Th3Ruiz/Proyecto-Dise-o-Mecatronico/Imagen proyecto final.jpg

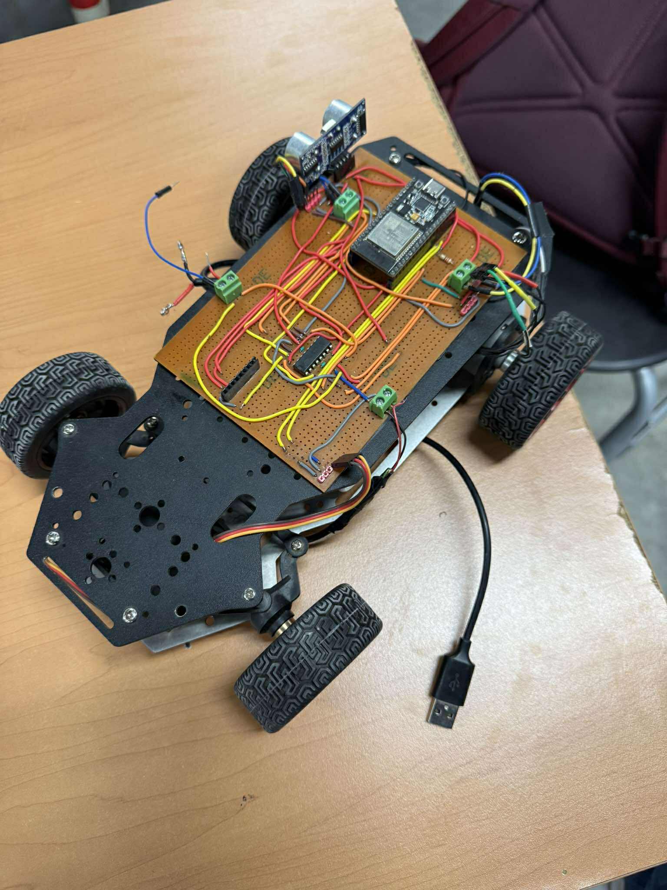
Imagen proyecto final.jpg
