Th3Ruiz/Proyecto-Dise-o-Mecatronico/Proyecto_diseno_mecatronico-3.pdf

Instituto de Ingeniería y Tecnología Diseño Mecatronico

# Sistema de Estacionamiento en Paralelo para Plaforma movil tipo Ackermann

Luis Armando Enciso Nava | 215766
Luis Eli Soto Arredondo | 201018
Francisco Javier Hernandez Gutierrez 201215
Angel Reynaldo Garcia Saucedo | 201957
Jorge Ivan Ruiz Espinoza | 201621

21 de mayo de 2025

## Índice

1. Introducción | 4
2. Desarrollo | 5
3. Anexos | 23

## Índice de figuras

1. | estacionamiento en paralelo | | 5
2. | Plataforma movil | | 6
3. | ESP32 | | 6
4. | Sensor láser | | 7
5. | Motoreductor de 12V | | 7
6. | Sensor de acelerómetro y giroscopio MPU-6050 | | 8
7. | Bateria de 12v | | 9
8. | Servmotor | | 9
9. Plano cartesiano en el primer cuadrante de tan⁻¹
| 10
10. Plano cartesiano en el primer cuadrante de tan⁻¹
(y, x) | 10
11. Diagrama del Sistema de Adquisición de datos y control del Robot Ackermann | 17
12. Chasis | 19
13. Centro de masa de Plataforma móvil | 21
14. Centro de cara de la rueda | 21
15. Representación de marcos coordenados aplicados a las ruedas y brazo de giro del sistema
móvil | 22
16. Planos de plataforma movil tipo ackermann | 29

## 1. Introducción

La adquisición de datos en un entorno dinámico es un proceso fundamental que permite la recopilación de información mediante diversos métodos y tecnologías, con el objetivo de analizar y comprender el funcionamiento del sistema en estudio. En la industria y la investigación, esta práctica se ha con-vertido en un pilar esencial, especialmente en el desarrollo de plataformas móviles capaces de ejecutar maniobras.
Este proyecto propone la implementación de un sistema de estacionamiento en paralelo para una plataforma con configuración Ackermann. Para ello, se utilizarán dispositivos ESP32, los cuales serán programados para que sean capaces tanto del control de movimientos de la plataforma móvil como de la recopilación y procesamiento de datos esenciales. A través de la programación, el sistema realizará las mediciones necesarias para ejecutar la maniobra de estacionamiento . Además, los datos obtenidos serán transmitidos a otros dispositivos, permitiendo así la simulación digital del movimiento y su implementación en el modelo físico.

### 1.1. Objetivo

Implementar un sistema de estacionamiento en paralelo para una plataforma móvil tipo Ackermann.

### 1.2. Objetivos Particulares

Equipar una plataforma móvil tipo Ackermann con un sistema con la propiedad de realizar maniobras de estacionamiento en paralelo.

Crear una representación tridimensional de la plataforma de manera sincronizada con su ejecución física.

Implementar un sistema de comunicación entre el microcontrolador, la simulación 3D y el robot móvil físico.

## 2. Desarrollo

### 2.1. Estacionamiento en Paralelo

Es una maniobra en la que se busca estacionar la plataforma movil ocupando el espacio entre dos objetos los cuales ya están previamente estacionados. Se define estacionamiento paralelo porque, una vez estacionado el automóvil luego de la maniobra, este queda en paralelo al borde de la calzada.

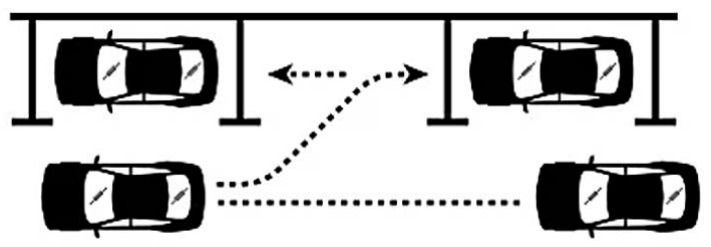
[picture p2: figure]

Figura 1: estacionamiento en paralelo

### 2.2. Plataforma de desarrollo robótico en Linux

Para esta parte se planea usar ROS2 que proviene de las siglas en inglés de Robot Operating System el cual es un conjunto de bibliotecas y herramientas de software que sirven para construir aplicaciones de robotica en linux. Desde controladores hasta algoritmos de vanguardia y con potentes herramientas para desarrollo. ROS2 tiene todo lo que se podría necesitar a la hora de realizar proyectos de robótica ademas es muy accesible ya que es de codigo abierto.

### 2.3. Lista de Materiales

Chasis con dirección tipo Ackerman

Microcontrolador ESP-32

Sensor láser ”time of flight”VL053X

Motores con Encoder de dos canales

Unidad de medición inercial MPU

Batería 12v 3600 mah

Servomotor MG996R

Buzzer

### 2.3.1. Chasis con direción tipo Ackerman

El chasis está equipado con un par de motores de reducción de CC de alto rendimiento, neumáticos de goma, servo digital MG-996R. El chasis adopta una estructura de aleación de aluminio totalmente metálica con una superficie anodizada. El chasis adopta una estructura de dirección Ackerman. Ambos motores cuentan con un encoder rotativo de dos canales, el cual necesita una alimentación de 3.3v para su correcto funcionamiento. Dichos motores funcionan con un voltaje de 12v.

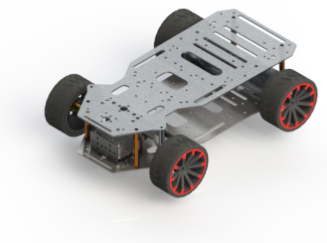
[picture p3: figure]

Figura 2: Plataforma movil

### 2.3.2. Microcontrolador ESP-32

El ESP32 es un microcontrolador creado por Espressif Systems. Este dispositivo es el sucesor del ESP8266. Tiene WiFi y Bluetooth y funciona con bajo consumo. Esto lo hace perfecto para proyectos que usan baterías. Además, es más rápido que un Arduino. Tiene pines sensibles al tacto y un sensor de efecto Hall.

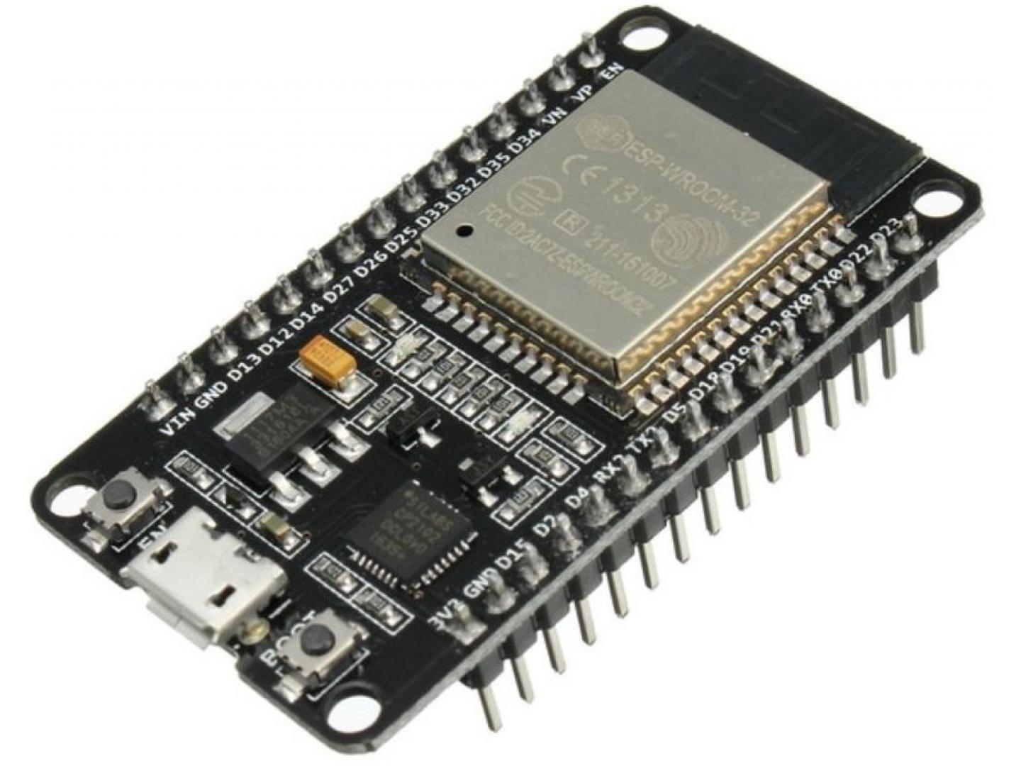
[picture p4: figure]

Figura 3: ESP32

### 2.3.3. Sensor láser ”time of fly”VL053X

Sensor laser, tambien llamado ”time of fly.es un sensor muy preciso el cual proyecta un laser para medir la distancia hacia un objeto

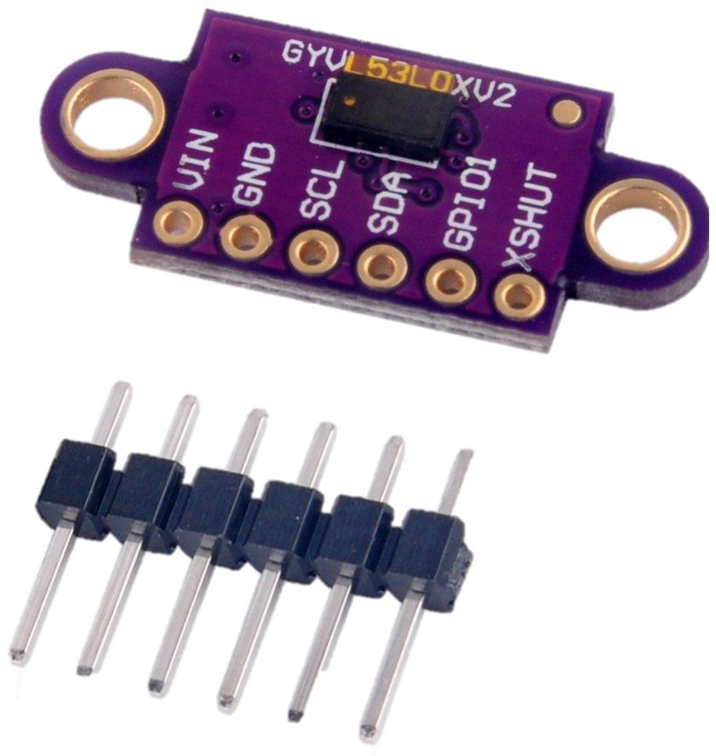
[picture p5: figure]

Figura 4: Sensor láser

### 2.3.4. Motorreductor 12V con encoder de dos canales

Motorreductor de 12 voltios, el cual tiene acoplado un encoder de dos canales de efecto hall de 350 rpm

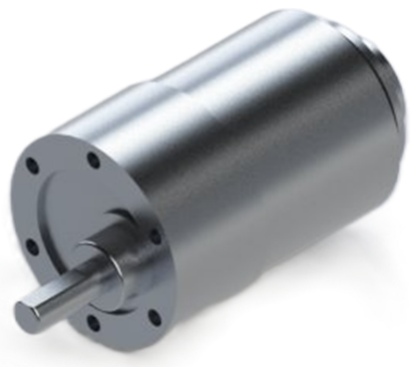
[picture p6: figure]

Figura 5: Motoreductor de 12V

### 2.3.5. MPU-6050

El MPU-6050 es una unidad de medición inercial (IMU) de seis grados de libertad (6DOF) fabricado por Invensense, que combina un acelerómetro de 3 ejes y un giroscopio de 3 ejes.

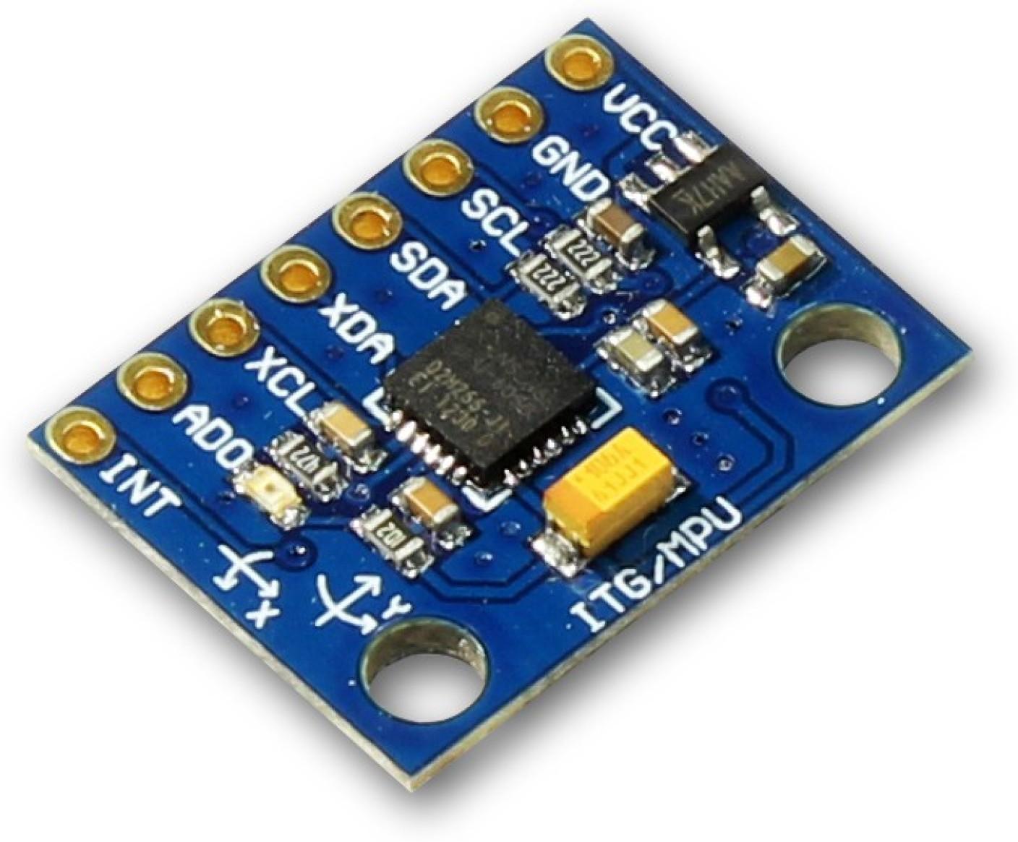
[picture p7: figure]

Figura 6: Sensor de acelerómetro y giroscopio MPU-6050

Acelerómetro

Mide la aceleración lineal en tres ejes (x, y, z ).

Detecta cambios en la velocidad del objeto.

Proporciona datos sobre la orientación del objeto en el espacio.

Giroscopio

Mide la rotación angular en tres ejes (x, y, z ).

Detecta cambios en la orientación del objeto.

Proporciona datos sobre la velocidad angular del objeto.

Funcionalidades del MPU6050

Detección de movimiento y orientación.

Estabilización de imágenes y videos.

Control de drones y robots.

Seguimiento de gestos y movimientos en dispositivos móviles.

Monitoreo de actividad física en dispositivos wearables.

Navegación en sistemas de posicionamiento global (GPS).

### 2.3.6. Bateria de 12V 3600 mah

Bateria de 12v de 3600 mah, ideal para alimentar nuestro circuito.

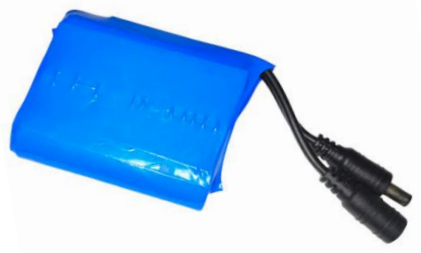
[picture p8: figure]

Figura 7: Bateria de 12v

### 2.3.7. Servomotor MG996R

Servo motor que será ocupado para la dirección de nuestro motor, dicho servomotor soporta hasta 10 kg y funciona con 5vdc.

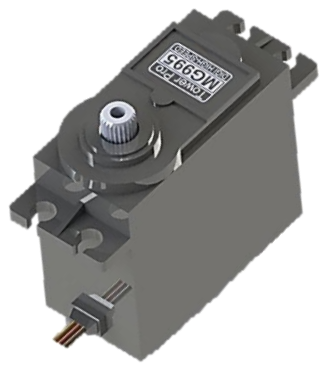
[picture p9: figure]

Figura 8: Servmotor

Algoritmos de Control y configuración
Implementaremos los algoritmos de control para los motores y el servomotor, usando Bluetooth para enviar comandos desde una aplicación de Android. Calcular RPM, velocidad angular y velocidad lineal a partir de las lecturas de los encoders.
Despues definiremos las configuraciones geométricas del sistema de dirección Ackermann y los ángulos de las ruedas, para garantizar un movimiento preciso y menor desgaste en las ruedas.
Teorema de tan⁻¹
(2)
La función tan⁻¹
(2) o tan⁻¹
(y, x), también conocida como la función arcotangente de dos parámetros, es una función matemática que calcula el ángulo θ entre el eje positivo de las x y el punto (x, y) en el plano cartesiano. Este ángulo θ se expresa en radianes y está limitado a un rango de −π a π.

tan⁻¹
(y, x) se utiliza para convertir coordenadas cartesianas (x, y) en coordenadas polares (r, θ), donde:

r = distancia desde el origen hasta el punto (x, y)

θ = es el angulo entre el x positivo y la linea que conecta con el origen en el punto (x, y).

Esta función toma en cuenta el signo de ambos parámetros para determinar el cuadrante correcto del angulo.

x

y

1 | 2 | 3

1

2

3

punto

Origen

Figura 9: Plano cartesiano en el primer cuadrante de tan⁻¹

x

y

1 | 2 | 3

1

2

3

punto

Origen

r

θ

Figura 10: Plano cartesiano en el primer cuadrante de tan⁻¹ (y, x)

Las figuras muestran un plano cartesiano donde se representa un punto en el primer cuadrante y la línea que une el origen con dicho punto. Usamos la función atan2(y,x) para calcular el ángulo de esta línea respecto al eje x positivo, ya que atan2 considera correctamente el signo de ambos parámetros, permitiendo identificar el cuadrante exacto. Esto es fundamental en la dirección Ackermann de un co-che, porque necesitamos conocer con precisión la orientación del vehículo para controlar adecuadamente el giro de las ruedas y su trayectoria.

Donde podemos aplicar este teorema:

Gráficos por computadora: Para rotar objetos en un plano.

Robótica: Para determinar la orientación de un robot en un espacio bidimensional.

Navegación: Para calcular la dirección entre dos puntos en un mapa

### 2.4. Dirección Ackerman

La ecuación para calcular el ángulo de dirección Ackerman en un sistema de dirección de una plataforma móvil programable se basa en la geometría de la configuración de las ruedas. La idea principal detrás del diseño de Ackermann es que las ruedas delanteras estén alineadas de manera que todos los radios de giro de las ruedas se crucen en el centro de rotación del vehículo, lo que minimiza el deslizamiento y el desgaste de las ruedas.
Este diseño se basa en la geometría de la configuración de las ruedas, donde los radios de giro de todas las ruedas se cruzan en un punto común, optimizando así la maniobrabilidad del vehículo. La fórmula básica para el ángulo de dirección Ackerman para las ruedas delanteras utilizando el teorema de tan⁻¹
(y, x) para obtener el ángulo de giro más exacto se muestra en la ecuación 1:

θi = tan⁻¹

L
Ri
(1)

donde:

θi es el ángulo de dirección de la rueda delantera medido en grados

i (donde i puede ser 1 o 2 para las ruedas del lado izquierdo o derecho, respectivamente)

L es la distancia entre el eje de las ruedas delanteras (ancho del tren delantero) medida en metros(m)

Ri es el radio de giro de la rueda i medida en metros(m)

Para un diseño de dirección Ackerman ideal, las ruedas delanteras deben estar orientadas de manera que todos los radios de giro de las ruedas se crucen en el mismo punto en el suelo. Esto asegura que las ruedas interiores y exteriores del vehículo giren con los ángulos adecuados para el radio de giro deseado.
Para calcular la velocidad lineal y angular de un vehículo que utiliza una dirección Ackerman, primero debemos entender cómo las ruedas afectan el movimiento del vehículo. Aquí está el proceso: La velocidad lineal (v) del vehículo se calcula como en la ecuación 2:
v = r · ω | (2)

donde:

r es el radio de giro del vehículo

ω es la velocidad angular de rotación del vehículo alrededor del centro de giro

La velocidad angular (ω) del vehículo se relaciona con el radio de giro (r) y la velocidad lineal (v) en la ecuación 3:

ω =

v
r

(3)

Cálculo del Radio de Giro
Para calcular el radio de giro usando tan⁻¹
(y, x), necesitamos expresar la relación en términos de coordenadas cartesianas (x, y). Podemos considerar:

x como la diferencia en la posición horizontal

y como la diferencia en la posición vertical

La ecuación para el radio de giro, llamada Ackermann, se representa en la ecuación 4:

Ackermann = tan⁻¹

d1

d1
tan(β) − d2

!
(4)

donde:

d1 es la distancia entre los ejes delantero y trasero del vehículo

d2 es la distancia entre las ruedas del mismo eje

β es el ángulo de giro interior de la rueda

Esta ecuación asegura que las ruedas del vehículo giren alrededor de un punto común, lo que mejora la estabilidad y reduce el desgaste de los neumáticos.

Angulo de giro de rueda interior ´

β = tan⁻¹

L
r −

W
2

!
(5)

donde:

L es la distancia entre ejes

r es el radio de giro

W es la distancia entre las ruedas del mismo eje (vía)

Angulo de giro de rueda exterior ´

α = tan⁻¹

L
r +

W
2

!
(6)

donde:

L es la distancia entre ejes (batalla)

r es el radio de giro

W es la distancia entre las ruedas del mismo eje (vía)

Porcentaje de Ackermann
El porcentaje de Ackermann se puede calcular como en la ecuación 7:

Porcentaje = 100 ·

# α Ackermann

(7)

Un 100 % de Ackermann significa que las prolongaciones de las bielas se cortan en el centro del eje trasero. En caso de que el porcentaje sea superior a 100, éstas se cortarán por delante del eje trasero; y detrás si es inferior.

2.5. Modelo matemático de estacionamiento en paralelo.

Para la plataforma movil tenemos una limitación mecánica por lo cual el angulo menor que se puede utilizar en el modelo es de 38 grados en la llanta interior de acuerdo al giro: esta limitación de angulo se obtiene con un servomotor el cual para obtener esos 38 grados se define por una escritura pwm en el servo con un angulo igual a 15 grados, que en traducción haciendo referencia a que los 90 grados son los 0 grados entonces el servomotor gira 75 grados hacia la derecha de acuerdo a su construcción teniendo en cuenta que ahora los 90 grados es el origen del giro.
Dado a que el carro puede alcanzar un ackermann al 100 % entonces las formulas del modelo se mantienen por lo cual:
cot(δL) − cot(δR) = TW
| W B

(8)

δAck =

δp
γ

(9)

δL = tan⁻¹

W B · tan(δAck)
W B + 0,5 · TW · tan(δAck)
(10)

δR = tan⁻¹

W B · tan(δAck)
W B − 0,5 · TW · tan(δAck)
(11)

Por lo tanto una función que dependa de δAck tal que nos proporcione los valores de los ángulos de las llantas seria:
(δL, δR) = f(δAck) | (12)

f(δAck) = tan⁻¹

W B · tan(δAck)
W B ± 0,5 · TW · tan(δAck)
(13)

En la cual la función radica en el mas menos para entregar los valores correspondientes para cada llanta, y sin importar el giro la evaluación en adición el angulo siempre sera correspondiente a la llanta del lado izquierdo y la evaluación en sustracción siempre sera correspondiente al lado derecho.
En donde:

δL Angulo de la llanta Izquierda.

δR Angulo de la llanta Derecha.

TW Ancho de vía.

W B Distancia entre ejes.

δAck Angulo Ackermann.

δp Angulo del piñón.

γ Relación de dirección.

Teniendo lo anterior en cuenta procedemos a sacar Rc la cual nos describirá el radio con el que debemos trabajar, por lo tanto:
La relación γ esta definida por la relación del angulo de giro del servomotor y el angulo de giro de la rueda central, al no tener rueda central, podemos optar por usar la función inversa, la cual parte de:

f(δAck) = tan⁻¹

W B · tan(δAck)
W B ± 0,5 · TW · tan(δAck)
(14)

(δL, δR) = tan⁻¹

W B · tan(δAck)
W B ± 0,5 · TW · tan(δAck)
(15)

Una vez teniendo la ecuación igualada a los valores que necesitamos encontrar comenzamos con el despeje:
tan(δL, δR) = | W B · tan(δAck)
W B ± 0,5 · TW · tan(δAck)

(16)

tan(δL, δR) (W B ± 0,5 · TW · tan(δAck)) = W B · tan(δAck) | (17)

W B · tan(δL, δR) ± 0,5 · TW · tan(δAck) · tan(δL, δR)
W B · tan(δAck)
= 1 | (18)

W B · tan(δL, δR)
W B · tan(δAck)

±

0,5 · TW · tan(δL, δR)
W B
= 1 | (19)

tan(δL, δR)
tan(δAck)

= 1 ∓

0,5 · TW · tan(δL, δR)
W B

(20)

1
tan(δAck)

=

1
tan(δL, δR)

±

0,5 · TW
W B

(21)

Hacemos una sustitución trigonométrica equivalente a 1/tan() lo que nos dejaría como:

cot(δAck) = cot(δL, δR) ±

0,5 · TW
W B

(22)

δAck = cot⁻¹

cot(δL, δR) ±

0,5 · TW

W B
(23)

δAck = f

−1
(δL, δR) | (24)

f

−1

(δL, δR) = cot⁻¹

cot(δL, δR) ±

0,5 · TW

W B
(25)

En la ecuación 25 sustituimos el valor de TW W B por la ecuación igualitaria (8) dejándonos así:

f

−1

(δL, δR) = cot⁻¹
(cot(δL, δR) ± 0,5 · (cot(δL) − cot(δR))) | (26)

f

−1

(δL, δR) = cot⁻¹
(cot(δL, δR) ± 0,5 · cot(δL) − 0,5 · cot(δR)) | (27)

f

−1

(δL) = cot⁻¹
(−0,5 · cot(δL) + 0,5 · cot(δR)) | (28)

f

−1

(δR) = cot⁻¹
(0,5 · cot(δL) + 0,5 · cot(δR)) | (29)

Por lo tanto:
f

−1
(δL) = −0,5 · δL + 0,5 · δR | (30)

f

−1
(δR) = 0,5 · δL + 0,5 · δR | (31)

La cual evaluamos con los valores de nuestro auto Ackermann corresponderían:

cot(δL) = 26◦

cot(δR) = 45◦

Por lo cual la evaluación correspondiente para cada una de ellas seria:

f

−1
(δL) = −0,5 · δL + 0,5 · δR | (32)

f

−1
(δR) = 0,5 · δL + 0,5 · δR | (33)

f

−1
(δL) = 22,5 − 13 | (34)

f

−1
(δR) = 22,5 + 13 | (35)

f

−1
(δL) = 9,5 | (36)

f

−1
(δR) = 35,5 | (37)

Como se puede ver al no ser una función lineal los el valor mas aproximado es de 35.5, por lo tanto procederemos a utilizar una función estable de un solo angulo la cual es:

f = tan⁻¹

d1
d1
tan(β)

− d2

(38)

### 2.6. Nodos y Tópicos

Nodo | Tipo | Descripción
esp32 sensores | Micro-ROS | Adquiere datos de sensores
esp32 control | Micro-ROS | Controla motores y dirección
parking controlador node | ROS 2 | Lógica de estacionamiento
gazebo sim node | Gazebo | Simulación
Rviz node | RViz | Visualización de datos

Cuadro 1: Nodos principales del sistema

Nodo | Tipo (Pub/Sub) | Tópicos | Tipo de Mensaje
esp32 sensores node | Publicador | /distancia/frontal(p) /distancia/trasera(p) /llantas/odometria(p) /imu/data raw(p) /servo/angulo(p) | sensor msgs/Range sensor msgs/Range nav msgs/Odometry sensor msgs/Imu std msgs/Float32
parking controlador node | Publicador/Suscriptor | /distancia/frontal(s) /distancia/trasera(s) /llantas/odometria(s) /imu/data raw(s) /servo/dataraw(s) /velocidad/angular(p) /velocidad/lineal(p) /direccion/angulo(p) /control/velocidad(p) | sensor msgs/Range sensor msgs/Range nav msgs/Odometry sensor msgs/Imu std msgs/Float32 geometry msgs/Twist geometry msgs/Twist std msgs/Float32 geometry msgs/Twist
esp32 control node | Suscriptor | /velocidad/angular(s) /velocidad/lineal(s) /direccion/angulo(s) | geometry msgs/Twist geometry msgs/Twist std msgs/Float32
gazebo ros node | Suscriptor | /direccion/angulo(s) /imu/data raw(s) /control/velocidad(s) /simulacion/odometria(p) | std msgs/Float32 sensor msgs/Imu geometry msgs/Twist nav msgs/Odometry
rviz node | Suscriptor | /simulacion/odometria(s) | nav msgs/Odometry

Cuadro 2: Diseño de nodos y tópicos para el sistema mecatrónico

En la tabla mostrada anteriormente se pueden observarr los nodos que serán utilizados en nuestro proyecto, destacando cuáless son publicadores y cuáless sonn suscriptores. De igual manera en la tercera columna de izquierda a derecha se muestran los tópicos de cada uno donde podemos destacar un (p) para el cual es un tópico el cual es publicado y una (s) para el tópico al cual se suscribe dicho nodo, finalmente en la ultima columna de nuestra tabla podemos ver el tipo de mensaje para cada tópico.

### 2.7. Micro-ROS

Micro-ROS es una herramienta necesaria para la comunicación entre un microcontrolador, como ESP32, y ROS2. Con esto podemos implementar las herramientas como RViz y Gazebo que permiten la visualización y la obtención de datos obtenidos de sensores. Este ejercicio se realizó en Ros 2 Humble, si deseas replicarlo hay que cambiar el nombre de dependencias a tu ROS instalado.
Se usará para:

Comunicación entre nodos, establecidos en el cuadro 2 de la sección 2.6, como publicadores y subscriptores.

Representación gráfica del modelo físico al gemelo virtual, en los cuales se realizará el movimiento.

Para la instalación de Micro-ROS con FreeRTOS que es el agente que permite la comunicación entre el ESP32 y ROS2, con los cuales obtenemos la lectura de sensores y de actuadores. La comunicación entre el ESP32 y el agente se basa por comunicación serial o por Wifi.

### 2.8. Lógica de estacionamiento

En el diseño del modelo de estacionamiento automático optamos por aplicar una serie de pasos y de condiciones, unas de las condiciones es pensar en diversificar los puntos de control en una rutina, de este modo empezamos la configuración con los sensores; el sensor ultra sónico acoplado en el chasis del automóvil, este se centrara en medir la diferencia de la distancia, dicha diferencia debe estar siendo calculada constantemente, y por consecuencia publicar el/los datos correspondientes.

Después estableceremos una velocidad para el automóvil, a la cual se suscribirá el controlador de los motores con encoder, los cuales a partir de los cálculos de radio y revoluciones por minuto de la rueda se seguirá la velocidad establecida en el publicador.

Así mismo utilizaremos un tercer controlador el cual se encargara de a través de una diferencia en el tiempo y suscrito a la diferencia de distancia del primer controlador y a la velocidad del automóvil podrá hacer cálculos en paralelo los cuales estarán orientados exclusivamente a determinar si el espacio calculado es el necesario para que el automóvil efectúe el intento de estacionamiento en paralelo, si el espacio no es el necesario el automóvil seguirá avanzando, en cambio si cumple las condiciones de espacio el automóvil empezara la etapa de estacionamiento automático.

Para esta secuencia se utilizaran los cálculos previamente realizador los cuales describen una línea a seguir, gracias a estos cálculos se configuraran los parámetros correspondientes para realizar un correcto seguimiento del calculo de estacionamiento, los cuales activaran el servomotor (el cual controla la dirección del carro) dándole el ángulo de giro correspondiente, se recorre una primera distancia para entrar al cajón de estacionamiento de reversa, después girara el servomotor para realizar un ajuste en la posición del carro dejando al carro estacionado y en la posición inicial.

Observe que las distancias se medirán utilizando el segundo y tercer controlador previamente men-cionados en la etapa de espacio necesario.

### 2.9. Arquitectura de Funcionamiento

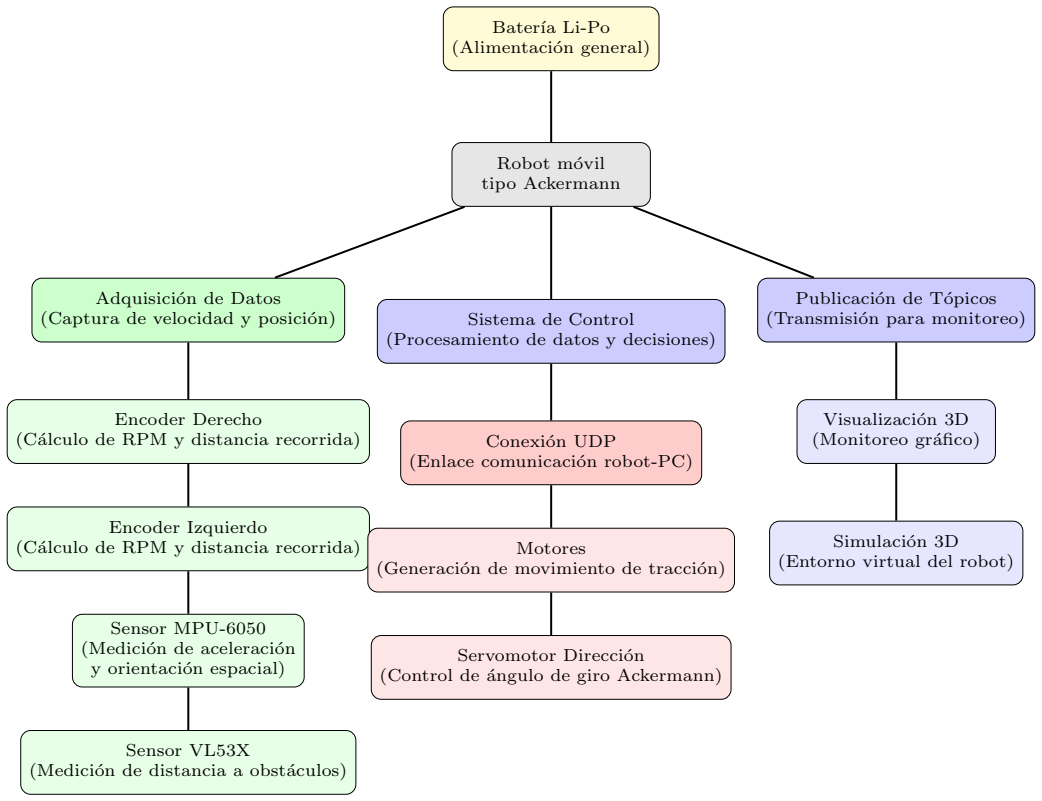
[picture p10: figure]
Robot móvil tipo Ackermann; Batería Li-Po (Alimentación general); Adquisición de Datos; (Captura de velocidad y posición); Sistema de Control; (Procesamiento de datos y decisiones); Publicación de Tópicos (Transmisión para monitoreo); Visualización 3D (Monitoreo gráfico); Simulación 3D (Entorno virtual del robot); Encoder Derecho (Cálculo de RPM y distancia recorrida); Encoder Izquierdo (Cálculo de RPM y distancia recorrida); Sensor MPU-6050 (Medición de aceleración y orientación espacial); Sensor VL53X (Medición de distancia a obstáculos)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

Sensores

Actuadores y Control

Comunicación y Visualización

Figura 11: Diagrama del Sistema de Adquisición de datos y control del Robot Ackermann.

### 2.10. Ecuaciones y cálculos de velocidad desde pulsos de encoder:

Para el cálculo de las revoluciones, se investigó la hoja de datos de nuestros motores la cual nos arrojó que nuestros encoders de efecto Hall nos proporcionan once pulsos por revolución.
Teniendo en cuenta el valor de los pulsos por revolución de nuestros motores y teniendo en cuenta la reación reductora de ambos motorreductores de nuestros motores de 12v DC que es de 1:90; quiere decir que por cada 90 vueltas de nuestros motores, el eje central de la caja reductora dará una vuelta. Gracias los pulsos por revolución y la relación de la caja reductora, podemos establecer el valor de los pulsos por revolución del eje de la caja recutora:
90 · 11 = 990 | (39)

90 = Relación reducora de la caja 1:90

11 = Pulsos por revolución

990 = Pulsos por revolución de la caja reductora

En la ecuación (8) se obtuvo el valor de los pulsos por revolución de un solo encoder, sin embargo, si medimos el cambio, el cual mide subidas y bajadas, este valor se duplicará, entonces obtenemos la ecuación(9):

RPM =

P ulsos · 60
990

(40)

Donde:

RPM = revoluciones por minuto

60 = 60 segundos que hay en un minuto

990 = Pulsos por revolución de la caja reductora

Una vez conocido el valor de las RPM gracias a la ecuación (9), se puede medir la velocidad angular mediante la ecuación (10):

ω =

2 · π · RPM
60

(41)

Donde:

ω = Velocidad angular medida en radianes/segundo(rad/s).

π = pi 3.1416

60 = segundos de un minuto

RPM = Revoluciones por minuto

Finalmente, gracias a la ecuación (10) podemos deducir la ecuación para obtener la velocidad lineal de nuestro robot mediante la siguiente ecuación:

V = ω · r | (42)

Donde:

V = velocidad lineal en centimetros/segundos(cm/s)

ω = velocidad angular

r = radio de la rueda de nuestros motores medida en centimetros

Consideraciones: Las ecuaciones (9 - 11) están dadas para el cálculo de 2 encoders, midiendo el cambio de la señal, sin embargo, habrá dos encoders por cada motor, por ende habrá 4 encoders, pero usarlos todos será opcional, sin embargo, en caso de usarlos, se puede realizar un promedio de ambas señales para obtener un valor general de pulsos y por ende, velocidad angular y velocidad lineal.

### 2.11. Modelo CAD

El modelo CAD (Diseño Asistido por Computadora) es una versión en 3D del sistema que estamos creando. Lo hicimos para tener una idea clara de cómo se vería el producto final. Para diseñarlo, usamos el programa SolidWorks y ahí armamos todas las piezas necesarias. Primero, medimos las partes físicas para poder dibujarlas en SolidWorks.
El modelo CAD incluye varios subensamblajes importantes, como la base, los actuadores, las placas electrónicas (PCBs) y los mecanismos de transmisión. Diseñamos cada parte pensando en las limita-ciones físicas y lo que necesitaba el proyecto.
También usamos la página GrabCAD para descargar algunas piezas extras y así completar el diseño, lo que nos ayudó a ahorrar tiempo.
Además, usamos la página web GrabCAD para descargar algunas piezas adicionales y así completar el diseño final del ensamblaje, ahorrando tiempo y facilitando el proceso.
Las medidas para recrear las bases del robot móvil están en la sección de Anexos, en la figura 30. Además, en la figura 28 de los Anexos, se muestra cómo se ven la dirección y los motores en el circuito real.

Modelo CAD del Sistema de Dirección Ackermann

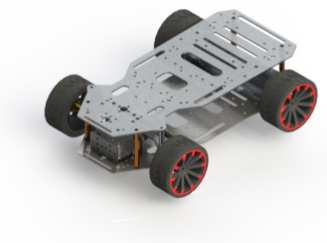
[picture p11: figure]

Figura 12: Chasis

### 2.12. URDF

Unified Robot Description Format (URDF) que es un archivo XML que permite describir un robot. Para exportar a Gazebo, donde se llevará acabo el Gemelo Virtual, es necesario exportar en formato URDF del sistema realizado en SolidWorks.
Se debe identificar los ”links ²

”joints.o eslabones y articulaciones del modelo, para ello se debe de seleccionar ”base link”que es lo que conforma todo lo del chasis de la plataforma móvil, incluyendo motores y el servomotor.
Una vez realizado el ”base link”se deben de realizar la selección de ”hijos”que estos son los que permitirán los movimientos continuos para el giro de las cuatro ruedas y dos movimientos de revolución el cual permitirán hacer el movimiento de Ackerman.
Para este trabajo se nombraron los links y joints de la siguiente manera:

Ruedas traseras – Movimiento continuo:

Rueda-derecha-trasera-link

Rueda-derecha-trasera-joint

Rueda-izquierda-trasera-link

Rueda-izquierda-trasera-joint

Ruedas delanteras – Movimiento de revolución:

Giro-derecho-delantera-link

Giro-derecho-delantera-joint

Giro-izquierdo-delantera-link

Giro-izquierdo-delantera-joint

Teniendo los movimientos de revolución, se deben aplicar como hijos las ruedas derecha e izquierda.

Ruedas delanteras – Movimiento continuo:

Rueda-derecha-delantera-link

Rueda-derecha-delantera-joint

Rueda-izquierda-delantera-link

Rueda-izquierda-delantera-joint

Como paso fundamental se debe tener el centro de masa de la plataforma se encuentre ubicado en el centro del chasis, como se muestra a continuación.

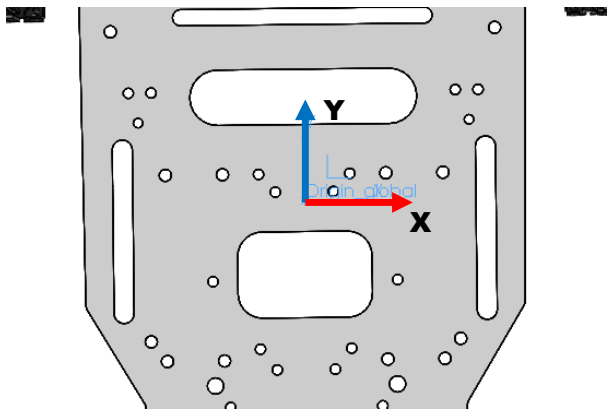
[picture p12: figure]

Figura 13: Centro de masa de Plataforma móvil

Como segundo paso, es necesario definir un centro de cara en cada una de las 4 ruedas de la plataforma móvil, con el cual obtendremos el marco coordenado con respecto a la regla de la mano derecha. De esta manera se puede determinar el eje de rotación y su giro de cada rueda.

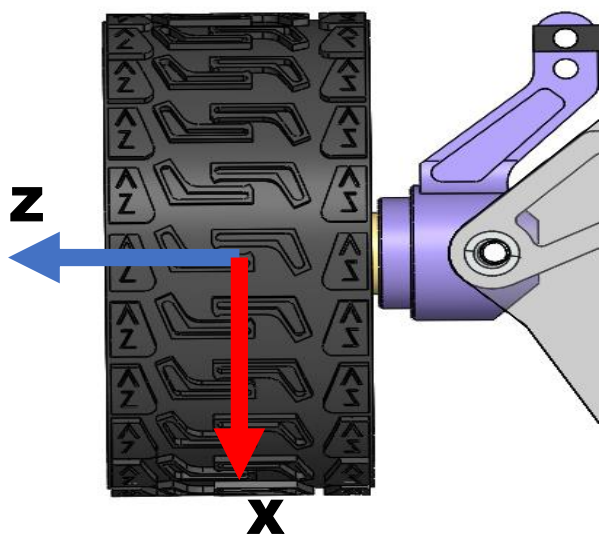
[picture p13: figure]

Figura 14: Centro de cara de la rueda.

Tercer paso, para las llantas delanteras, además de contar con el marco coordenado de las ruedas, también se necesita ubicar un segundo marco coordenado en el brazo de dirección, el cual es el que permite el movimiento del giro.

Z

X

(a) Mambos ejes, en la rueda y el en el brazo donde se realizará el movimiento de giro

X

Y

Z

(b) Marco coordenado para movimiento de Ackermann

Figura 15: Representación de marcos coordenados aplicados a las ruedas y brazo de giro del sistema móvil.

Una vez realizado estos pasos ya se podrá obtener el archivo que permitirá la visualización del urdf. Debemos tener en cuenta que hay que poner los marcos coordenados correctamente, poner los límites en los que se pueden rotar o girar las ruedas, todo esto para poder simular correctamente el modelo en un entorno de software, como Gazebo.

## 3. Anexos

La instalación de este agente se realizó siguiendo los pasos del repositorio oficial de ROS ”primera aplicación con micro-Ros con FreeRTOS
Los pasos realizados en la terminal son los siguientes:
Activación de la instalación de ROS 2 en la terminal, este comando funge como señal para usar ROS 2.

1 source / opt / ros / $ROS_DISTRO / setup . bash

Creación de carpeta de trabajo, donde se realizará el trabajo con respecto a Micro-ros.

1 mkdir microros_ws

Este comando permite meternos a la carpeta creada anteriormente.

1 cd microros_ws

Permite la descarga de herramientas y librerías de Github, de la versión en la se esta trabajando, este caso la utilización de ”Humble”

1 | git clone -b $ROS_DISTRO https :// github . com / micro - ROS / micro_ros_setup . git src /
| micro_ros_setup

Sudo apt update funge como la actualización de paquetes de Ros2, mientras que rosdep update funge para para ctualizar la herramienta rosdep, que es la que permite la instalación de dependencias de ROS.

1 sudo apt update && rosdep update

Este comando permite instalar todos los paquetes necesarios para que realice el correcto funcionamiento de librerías.

1 Rosdep install -- from - paths src -- ignore - src -y

Instalación de Pip, que permite gesionar y descargar librerías de Python para la utilización de Micro-ROS

1 sudo apt - get install python3 - pip

Comando que permite la creación de todo lo realizado con anterioridad en el espacio de trabajo creado üros ws”

1 colcon build

Para inicializar el espacio de trabajo creado de micro-ROS, junto con la implementación de paquetes de ROS2

1 source install / local_setup . bash

Ya una vez realizado los pasos anteriores, se realizará lo siguiente.
En este paso, se crea un espacio de trabajo para firmware, que es el que permitirá la comunicación entre ESP32 y ROS 2, el cual permite leer sensores o controle actuadores. Este paso es tardado, puesto que instala los paquetes necesarios para su funcionamiento.

1 ros2 run micro_ros_setup create_firmware_ws . sh freertos esp32

Una vez ya descargado todos los paquetes, se procede a gestionar los archivos instalados.

1 | cd microros_ws
2 | / microros_ws / ls
3 | / microros_ws / ls / firmaware
4 | / microros_ws / ls / firmaware / ls
5 | / microros_ws / ls / firmaware / cd freertos_apps /
6 | / microros_ws / ls / firmaware / freertos_apps / ls
7 | / microros_ws / ls / firmaware / freertos_apps / cd apps /

Estando en esta sección deberá aparecer aparecer las aplicaciones para la realización en este caso guiados de la pagina oficial de ROS, el ejemplo ”Ping pong”.

1 / microros_ws / ls / firmaware / freertos_apps / apps / ls

Comando a realizar para configurar la aplicación por via puerto serial y lograr la comunicación entre ESP32 Y Micro ROS.

1 ros2 run micro_ros_setup configure_firmware . sh ping_pong -- transport serial

En este paso construimos el firmware para usar el protocolo ”ping pong”, enviando y recibiendo información.

1 ros2 run micro_ros_setup build_firmware . sh

Paso de flash, en este paso tenemos que tener conectado el ESP32 a la computadora por puerto USB

1 ros2 run micro_ros_setup flash_firmware . sh

Descargamos todos los paquetes del agente de Micro-ROS para la comunicación con ROS 2. Estos paquetes son bastantes, así que puede variar el tiempo en su descarga.

1 ros2 run micro_ros_setup create_agent_ws . sh

Se construyen los paquetes descargados del agente.

1 ros2 run micro_ros_setup build_agent . sh

Activación de paquetes descargados.

1 source install / local_setup . bash

Antes de corroborar el funcionamiento de este firmware, se debe de poner el siguiente comando, para saber con exactitud la dirección en el que esta conectado el ESP32.

1 / dev / serial / by - id /*

En este caso a nosotros nos arrojo la siguiente ubicación en donde esta conectado el ESP32.

1 | / dev / serial / by - id / usb - Silicon_Labs_CP2102_USB_to_UART_Bridge_Controller_0001 - if00 -
| port0

Ya obtenido la dirección de conexión del ESP32, se debe poner el siguiente comando.

1 ros2 run micro_ros_agent micro_ros_agent serial -- dev

Juntamos la dirección obtenida con el comando anterior, en este paso debemos de presionar el botón BOOT del ESP32 para acompletar la conexión. Realizado este comando debe de haber conexión establecida.

1 | ros2 run micro_ros_agent micro_ros_agent serial -- dev / dev / serial /by - id / usb -
| Silicon_Labs_CP2102_USB_to_UART_Bridge_Controller_0001 - if00 - port0

Para confirmar la comunicación se debe de abrir otra terminal y correr el siguiente comando.

1 ros2 topic list

Una vez puesto ese comando, deben aparecer los siguientes Tópicos y eso es señal de una comunicación entre ESP32 y Micro-Ros.

1 | / microRos / ping
2 | / microRos / pong

### 3.1. Codigo de Microros:

1 | # include < micro_ros_arduino .h >
2 | # include < rcl / rcl .h >
3 | # include < rclc / rclc .h >
4 | # include < rclc / executor .h >
5 | # include < geometry_msgs / msg / twist .h >
6 | # include < std_msgs / msg / float32 .h >
7 | # include < sensor_msgs / msg / imu .h >
8 | # include < ESP32Servo .h >
9 | # include < Adafruit_MPU6050 .h >
10 | # include < Adafruit_Sensor .h >
11 | # include < Wire .h >

12
13 | # define SERVO_PIN 13
14 | # define TRIG_PIN 12
15 | # define ECHO_PIN 14
16 | # define ENCODER_PIN 15

17
18 | # define ENA 32
19 | # define ENB 33
20 | # define IN1 2
21 | # define IN2 4
22 | # define IN3 16
23 | # define IN4 17

24
25 | const int VELOCIDAD_LENTA = 200;
26 | const int PULSOS_POR_VUELTA = 1346;
27 | const float DISTANCIA_CM_POR_PULSO = 21.99 / PULSOS_POR_VUELTA ;

28
29 | const int PULSOS_DIAGONAL = 400;
30 | const int PULSOS_RECTO = 350;
31 | const int PULSOS_AJUSTE = 400;
32 | const int PULSOS_AVANCE = 50;

33
34 | volatile long contador_pulsos = 0;
35 | Servo direccion ;
36 | Adafruit_MPU6050 mpu ;
37 | bool maniobra_realizada = false ;

38
39 | rcl_publisher_t twist_publisher ;
40 | rcl_publisher_t distance_publisher ;
41 | rcl_publisher_t imu_publisher ;
42 | geometry_msgs__msg__Twist twist_msg ;
43 | std_msgs__msg__Float32 distance_msg ;
44 | sensor_msgs__msg__Imu imu_msg ;
45 | rclc_executor_t executor ;
46 | rclc_support_t support ;
47 | rcl_allocator_t allocator ;
48 | rcl_node_t node ;

49
50 | void IRAM_ATTR contarPulsos () {
51 | contador_pulsos ++;
52 | }

53
54 | void setupMicroROS () {
55 | set_microros_transports () ;
56 | allocator = rcl_get_default_allocator () ;
57 | rclc_support_init (& support , 0, NULL , & allocator );
58 | rclc_node_init_default (& node , " esp32_robot ", "" , & support );
59 | rclc_publisher_init_default (& twist_publisher , & node , ROSIDL_GET_MSG_TYPE_SUPPORT (
| geometry_msgs , msg , Twist ) , " model / robot / cmd_vel ") ;
60 | rclc_publisher_init_default (& distance_publisher , & node , ROSIDL_GET_MSG_TYPE_SUPPORT (
| std_msgs , msg , Float32 ) , " distancia ") ;
61 | rclc_publisher_init_default (& imu_publisher , & node , ROSIDL_GET_MSG_TYPE_SUPPORT (
| sensor_msgs , msg , Imu ) , " imu / data ") ;
62 | rclc_executor_init (& executor , & support . context , 1 , & allocator ) ;
63 | }

64
65 | void setupMPU6050 () {
66 | mpu . begin () ;

67 | mpu . setAccelerometerRange ( MPU6050_RANGE_8_G );
68 | mpu . setGyroRange ( MPU6050_RANGE_500_DEG );
69 | mpu . setFilterBandwidth ( MPU6050_BAND_21_HZ );
70 | }

71
72 | void publishIMUData () {
73 | sensors_event_t a , g , temp ;
74 | mpu . getEvent (& a , &g , & temp );
75 | int64_t time_now = rmw_uros_epoch_millis () ;
76 | imu_msg . header . stamp . sec = time_now / 1000;
77 | imu_msg . header . stamp . nanosec = ( time_now % 1000) * 1000000;
78 | imu_msg . linear_acceleration .x = a. acceleration .x;
79 | imu_msg . linear_acceleration .y = a. acceleration .y;
80 | imu_msg . linear_acceleration .z = a. acceleration .z;
81 | imu_msg . angular_velocity .x = g. gyro .x * ( M_PI / 180.0) ;
82 | imu_msg . angular_velocity .y = g. gyro .y * ( M_PI / 180.0) ;
83 | imu_msg . angular_velocity .z = g. gyro .z * ( M_PI / 180.0) ;
84 | rcl_publish (& imu_publisher , & imu_msg , NULL ) ;
85 | }

86
87 | void publishDistance ( float distancia ) {
88 | distance_msg . data = distancia ;
89 | rcl_publish (& distance_publisher , & distance_msg , NULL ) ;
90 | }

91
92 | void publicarVelocidades ( float lineal , float angular ) {
93 | twist_msg . linear .x = lineal ;
94 | twist_msg . angular .z = angular ;
95 | rcl_publish (& twist_publisher , & twist_msg , NULL );
96 | }

97
98 | void moverAdelanteIndefinido () {
99 | digitalWrite ( IN1 , HIGH );
100 | digitalWrite ( IN2 , LOW );
101 | digitalWrite ( IN3 , HIGH );
102 | digitalWrite ( IN4 , LOW );
103 | analogWrite ( ENA , VELOCIDAD_LENTA );
104 | analogWrite ( ENB , VELOCIDAD_LENTA );
105 | publicarVelocidades (0.10 , 0.0) ;
106 | }

107
108 | void moverAdelanteTiempo ( int ms ) {
109 | digitalWrite ( IN1 , HIGH );
110 | digitalWrite ( IN2 , LOW );
111 | digitalWrite ( IN3 , HIGH );
112 | digitalWrite ( IN4 , LOW );
113 | analogWrite ( ENA , VELOCIDAD_LENTA );
114 | analogWrite ( ENB , VELOCIDAD_LENTA );
115 | publicarVelocidades (0.10 , 0.0) ;
116 | delay ( ms ) ;
117 | detenerMotores () ;
118 | }

119
120 | void moverAtras ( long pulsos_objetivo ) {
121 | contador_pulsos = 0;
122 | digitalWrite ( IN1 , LOW );
123 | digitalWrite ( IN2 , HIGH );
124 | digitalWrite ( IN3 , LOW );
125 | digitalWrite ( IN4 , HIGH );
126 | analogWrite ( ENA , VELOCIDAD_LENTA );
127 | analogWrite ( ENB , VELOCIDAD_LENTA );
128 | publicarVelocidades ( -0.10 , 0.0) ;
129 | while ( contador_pulsos < pulsos_objetivo ) {
130 | publishIMUData () ;
131 | delay (10) ;
132 | }
133 | detenerMotores () ;
134 | }

135
136 | void detenerMotores () {
137 | digitalWrite ( IN1 , LOW );

138 | digitalWrite ( IN2 , LOW );
139 | digitalWrite ( IN3 , LOW );
140 | digitalWrite ( IN4 , LOW );
141 | analogWrite ( ENA , 0) ;
142 | analogWrite ( ENB , 0) ;
143 | publicarVelocidades (0.0 , 0.0) ;
144 | }

145
146 | float leerDistancia () {
147 | digitalWrite ( TRIG_PIN , LOW );
148 | delayMicroseconds (2) ;
149 | digitalWrite ( TRIG_PIN , HIGH );
150 | delayMicroseconds (10) ;
151 | digitalWrite ( TRIG_PIN , LOW );
152 | long duracion = pulseIn ( ECHO_PIN , HIGH , 20000) ;
153 | float distancia = duracion * 0.034 / 2.0;
154 | publishDistance ( distancia );
155 | return distancia ;
156 | }

157
158 | void fase1RetrocederDiagonal () {
159 | direccion . write (140) ;
160 | publicarVelocidades ( -0.10 , 0.5) ;
161 | moverAtras ( PULSOS_DIAGONAL );
162 | }

163
164 | void fase2RetrocederRecto () {
165 | direccion . write (90) ;
166 | publicarVelocidades ( -0.10 , 0.0) ;
167 | moverAtras ( PULSOS_RECTO );
168 | }

169
170 | void fase3RetrocederAjustando () {
171 | direccion . write (40) ;
172 | publicarVelocidades ( -0.10 , -0.5) ;
173 | moverAtras ( PULSOS_AJUSTE );
174 | }

175
176 | void fase4AvanzarCentrar () {
177 | direccion . write (90) ;
178 | publicarVelocidades (0.10 , 0.0) ;
179 | moverAdelanteTiempo (1000) ;
180 | }

181
182 | void ejecutarSecuenciaEstacionamiento () {
183 | fase1RetrocederDiagonal () ;
184 | fase2RetrocederRecto () ;
185 | fase3RetrocederAjustando () ;
186 | fase4AvanzarCentrar () ;
187 | }

188
189 | void setup () {
190 | Serial . begin (115200) ;
191 | delay (2000) ;
192 | direccion . attach ( SERVO_PIN );
193 | direccion . write (90) ;
194 | pinMode ( TRIG_PIN , OUTPUT );
195 | pinMode ( ECHO_PIN , INPUT ) ;
196 | pinMode ( ENCODER_PIN , INPUT_PULLUP ) ;
197 | attachInterrupt ( digitalPinToInterrupt ( ENCODER_PIN ) , contarPulsos , FALLING );
198 | pinMode ( ENA , OUTPUT ) ;
199 | pinMode ( ENB , OUTPUT ) ;
200 | pinMode ( IN1 , OUTPUT ) ;
201 | pinMode ( IN2 , OUTPUT ) ;
202 | pinMode ( IN3 , OUTPUT ) ;
203 | pinMode ( IN4 , OUTPUT ) ;
204 | Wire . begin () ;
205 | setupMPU6050 () ;
206 | setupMicroROS () ;
207 | detenerMotores () ;
208 | }

210 | void loop () {
211 | static unsigned long last_imu_publish = 0;
212 | if ( millis () - last_imu_publish > 100) {
213 | publishIMUData () ;
214 | last_imu_publish = millis () ;
215 | }
216 | if (! maniobra_realizada ) {
217 | float distancia = leerDistancia () ;
218 | if ( distancia > 0 && distancia < 25) {
219 | moverAdelanteTiempo (1700) ;
220 | detenerMotores () ;
221 | ejecutarSecuenciaEstacionamiento () ;
222 | maniobra_realizada = true ;
223 | } else {
224 | moverAdelanteIndefinido () ;
225 | }
226 | } else {
227 | detenerMotores () ;
228 | }
229 | rclc_executor_spin_some (& executor , RCL_MS_TO_NS (100) );
230 | }

### 3.2. Comandos para la inicializacion en ros2:

### 3.3. Iniciar microros

1 | ros2 run micro_ros_agent micro_ros_agent serial -- dev / dev / serial /by - id / usb - Silicon_Labs_CP2102_USB_to_UART_Bridge_Controller_0001 - if00 - port0

### 3.4. Iniciar gazebo

1 | ros2 launch mobile_robot gazebo_model . launch . py

### 3.5. Vizualizar topicos de microros

1 | ros2 topic list

### 3.6. Vizualizar sensores y actuadores

1 | ros2 topic lecho \

0,03

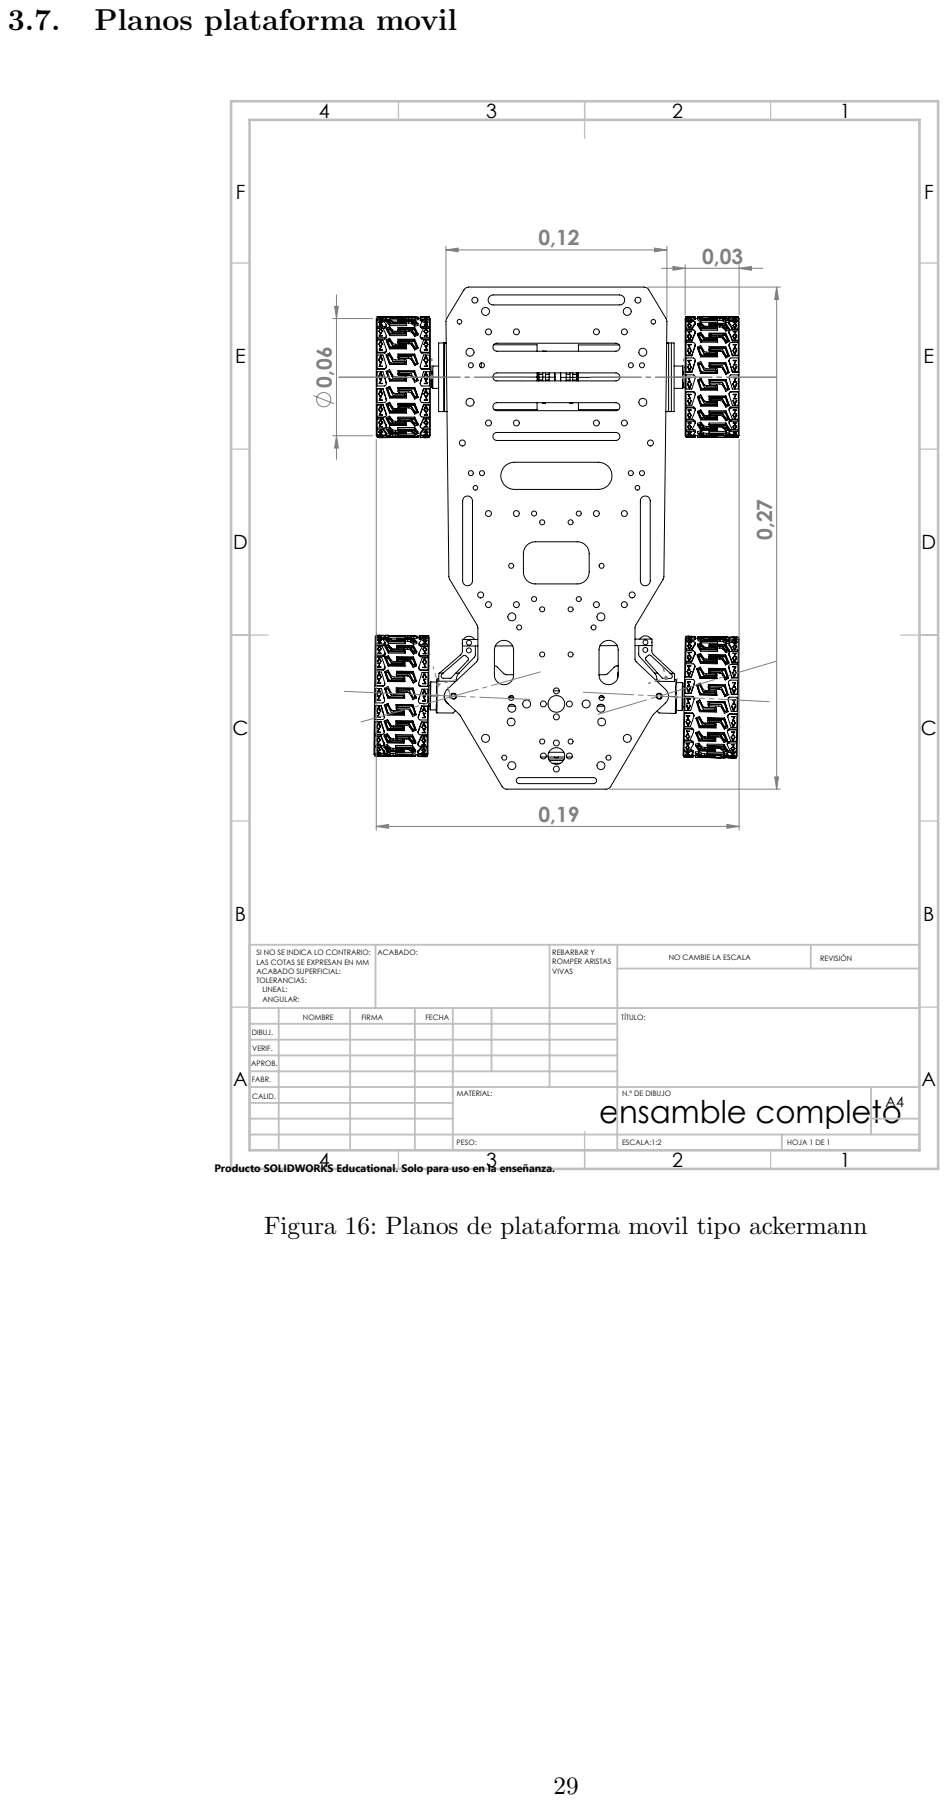
[picture p14: page 29]
Planos plataforma movil; ACABADO:; REBARBAR Y; ROMPER ARISTAS VIVAS; NO CAMBIE LA ESCALA; REVISIÓN; ESCALA:1:2; HOJA 1 DE 1; PESO:

SI NO SE INDICA LO CONTRARIO:
LAS COTAS SE EXPRESAN EN MM
ACABADO SUPERFICIAL:
TOLERANCIAS:
LINEAL:
ANGULAR:

NOMBRE | FIRMA | FECHA | | | | TÍTULO:

DIBUJ.
VERIF.
APROB.
FABR.
CALID. | | | | MATERIAL: ensamble completo | N.º DE DIBUJO | A4

Producto SOLIDWORKS Educational. Solo para uso en la enseñanza.

Figura 16: Planos de plataforma movil tipo ackermann

### 3.8. Renders

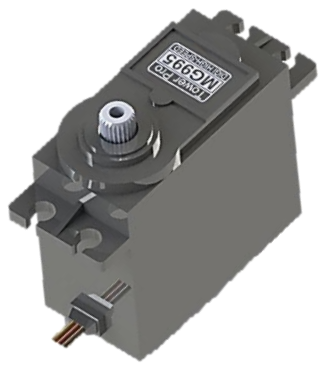
[picture p15: figure]

(a) Render de un servo motor MG996R hecho en solidworks

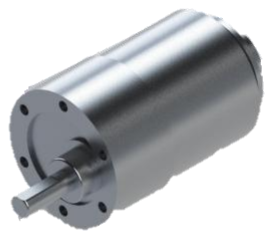
[picture p16: figure]

(b) Render del motor de 12v de 350 rpm hecho en solidworks

## Referencias

[1] Ingenieria | Y | Mecanica | Automotriz, | “Qué | es | y | como | funciona | el | prin-
cipio | de | Ackerman?,” | Ingenieria | Y | Mecanica | Automotriz, | Oct. | 2019.
[Online]. | Available: | https://www.ingenieriaymecanicaautomotriz.com/
que-es-y-como-funciona-el-principio-de-ackerman/. (https://www.ingenieriaymecanicaautomotriz.com/que-es-y-como-funciona-el-principio-de-ackerman/) [Accessed: Oct. 2, 2024].
[2] E. | Roch | Moraguez, | “Todo | sobre | ESP32: | Guía | y | Aplicaciones | Prácticas,”
LovTechnology, | Jun. | 2024. | [Online]. | Available: | https://lovtechnology.com/
todo-sobre-esp32-guia-y-aplicaciones-practicas/. (https://lovtechnology.com/todo-sobre-esp32-guia-y-aplicaciones-practicas/) [Accessed: Oct. 2, 2024].
[3] J. L. R., “Baterías de Litio — Qué son, funcionamiento, partes y usos,” 247Tecno, Oct. 2019. [Online]. Available: https://247tecno.com/baterias-de-litio/. [Accessed: Oct. 2, 2024].
[4] Ingeniería Mecafenix, “Qué es el buzzer y cómo funciona (zumbador),” Mecafenix, Dec. 2023. [Online]. Available: https://www.ingmecafenix.com/electronica/componentes/el-buzzer/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,una%20bater%C3%ADa%20o%20cualquier%20fuente%20de%20corriente%20directa. (https://www.ingmecafenix.com/electronica/componentes/el-buzzer/) [Accessed: Oct. 2, 2024].
[5] L. Llamas, “Determinar la orientación con Arduino y el IMU MPU-6050,” Luis Llamas, Sep. 2016. [Online]. Available: https://www.luisllamas.es/arduino-orientacion-imu-mpu-6050/. [Accessed: Oct. 2, 2024].
[6] Open Robotics, “ROS (Robot Operating System),” ROS.org, 2007. [Online]. Available: https: //www.ros.org. [Accessed: Apr. 4, 2025].
