Th3Ruiz/Proyecto-Dise-o-Mecatronico/DisM_Expo_3er_parcial.pptx

## Sistema de estacionamiento en paralelo para plataforma móvil tipo Ackermann

Luis Armando Enciso Nava 215766
Luis Eli Soto Arredondo 201018
Francisco Javier Hernandez Gutierrez 201215 Angel Reynaldo Garcia Saucedo 201957
Jorge Ivan Ruiz EspinozA 201621

## Micro-ROS

- Es un entorno para programar microcontroladores en ROS2.
- Tiene librerías y paquetes dedicados a la programación de microcontroladores.
- Ayuda a tener una lectura de sensores eficiente.
- Tiene comunicación entre Nodos.

## SIMULACION

- Rviz2

- Gazebo

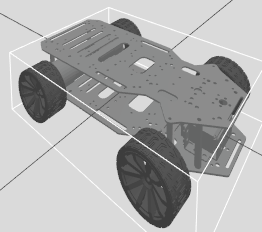
[picture p17: figure]
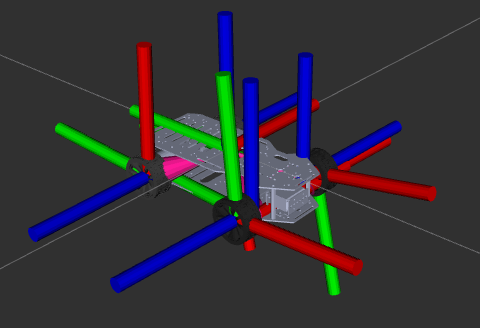
[picture p18: figure]

## Slide 4

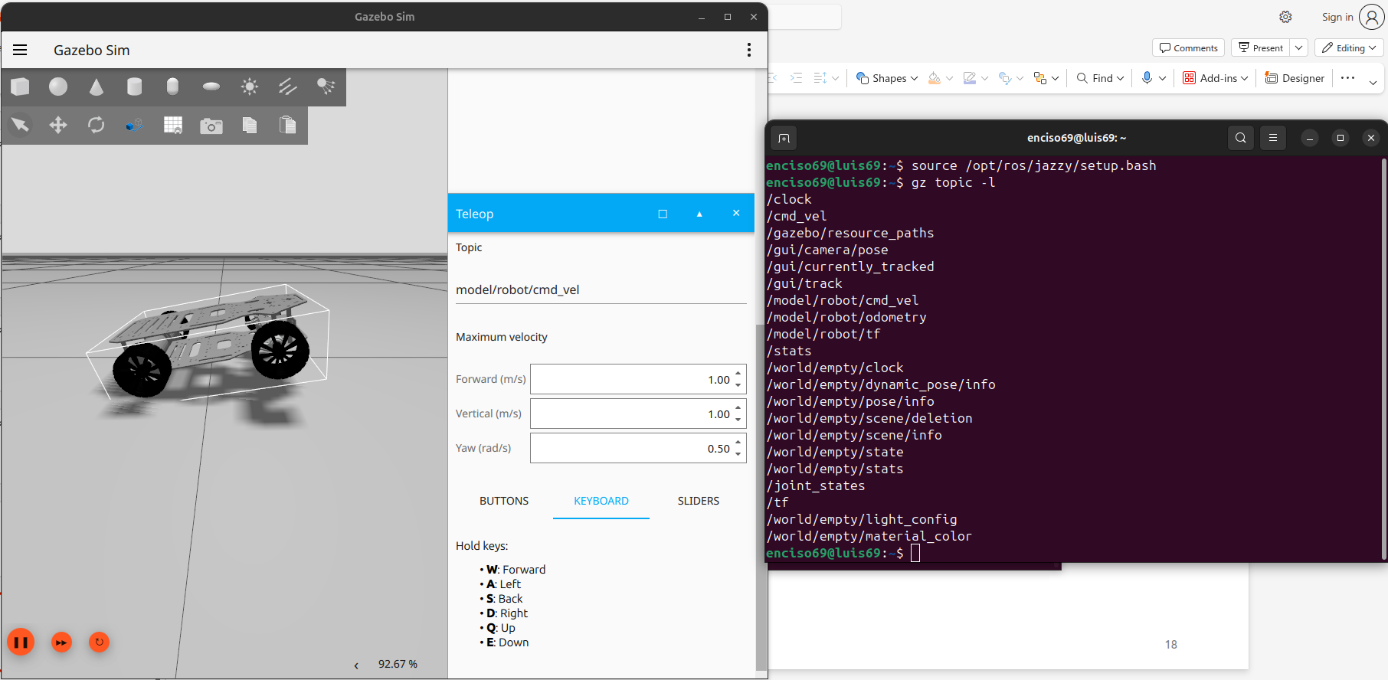
[picture p19: figure]

## Slide 5

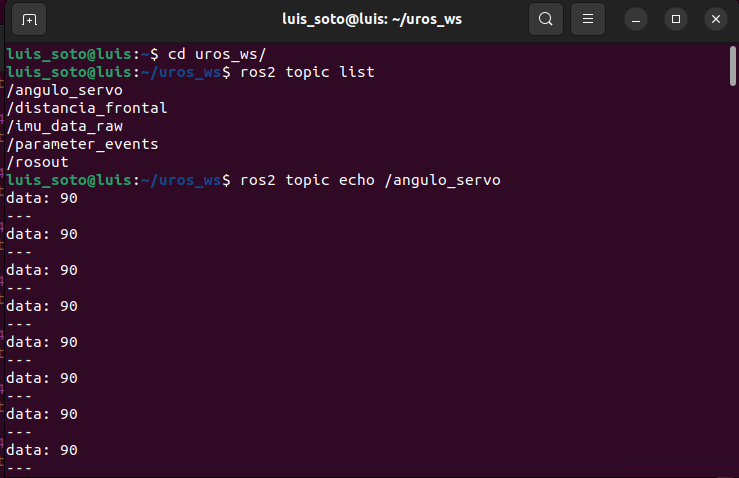
[picture p20: figure]
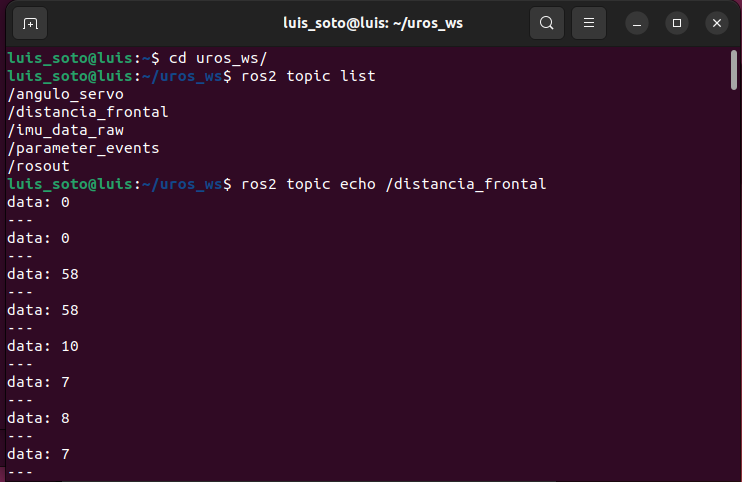
[picture p21: figure]

## Slide 6

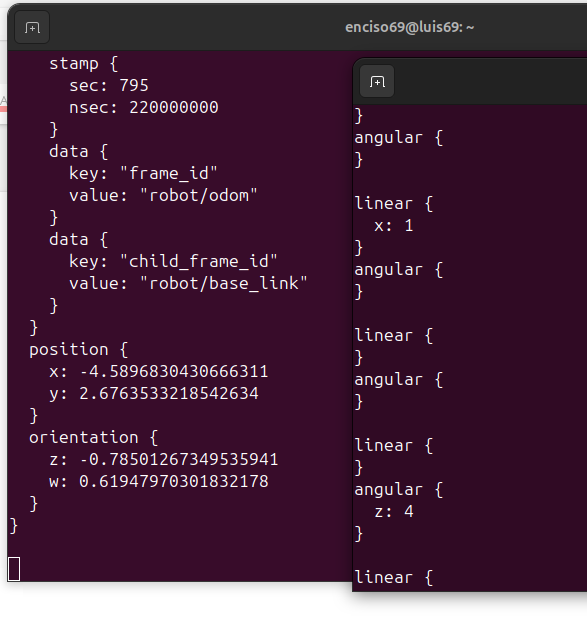
[picture p22: figure]
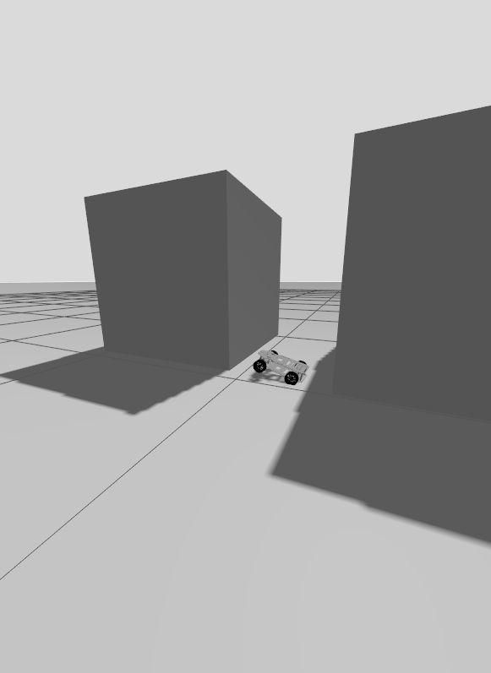
[picture p23: figure]

## THANK YOU

Luis Armando Enciso Nava 215766
Luis Eli Soto Arredondo 201018
Francisco Javier Hernandez Gutierrez 201215 Angel Reynaldo Garcia Saucedo 201957
Jorge Ivan Ruiz EspinozA 201621

Sistema de Estacionamiento en Paralelo para plataforma móvil tipo Ackermann
